wolfmanjm/wolfstock/circuits/mosfetpcb.png

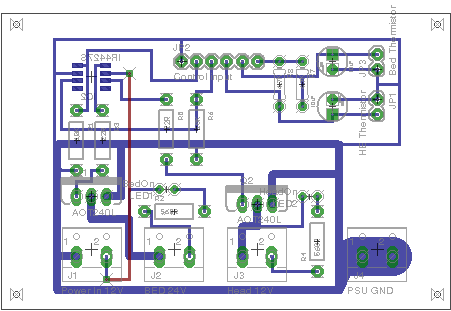
circuits/mosfetpcb.png
