wolfmanjm/wolfstock/circuits/mosfetsch.png

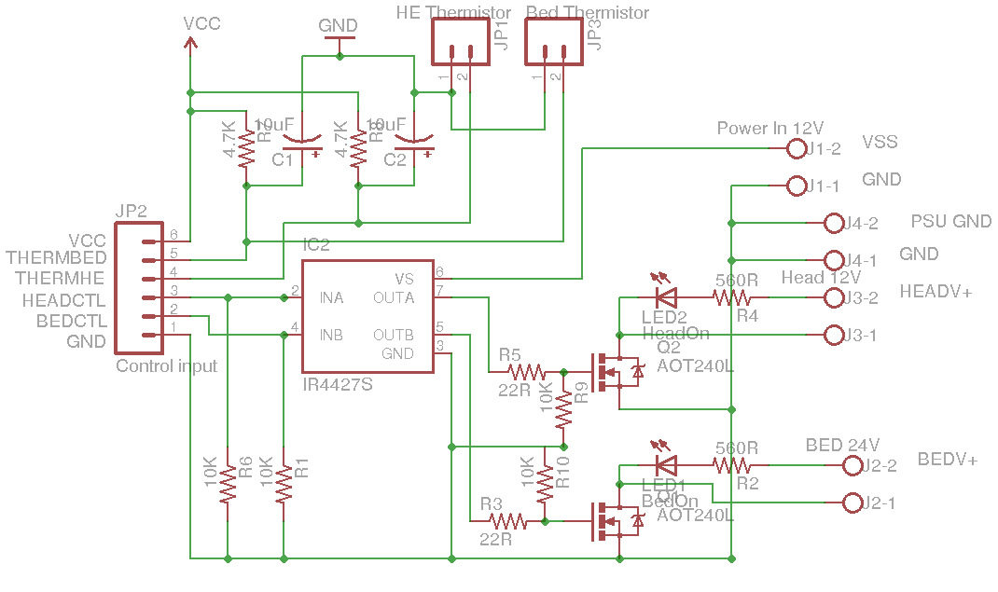
circuits/mosfetsch.png
