wolfmanjm/wolfstock/img/belt-idler.png

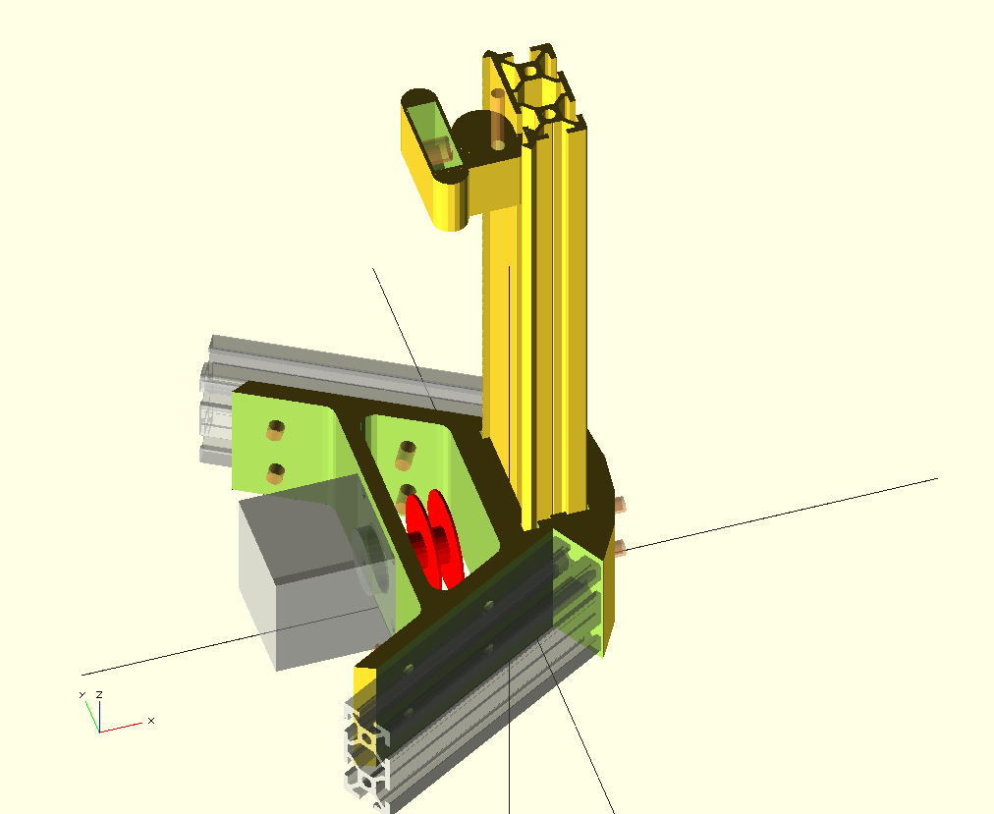
img/belt-idler.png
