wolfmanjm/wolfstock/img/g2-belt-idler.png

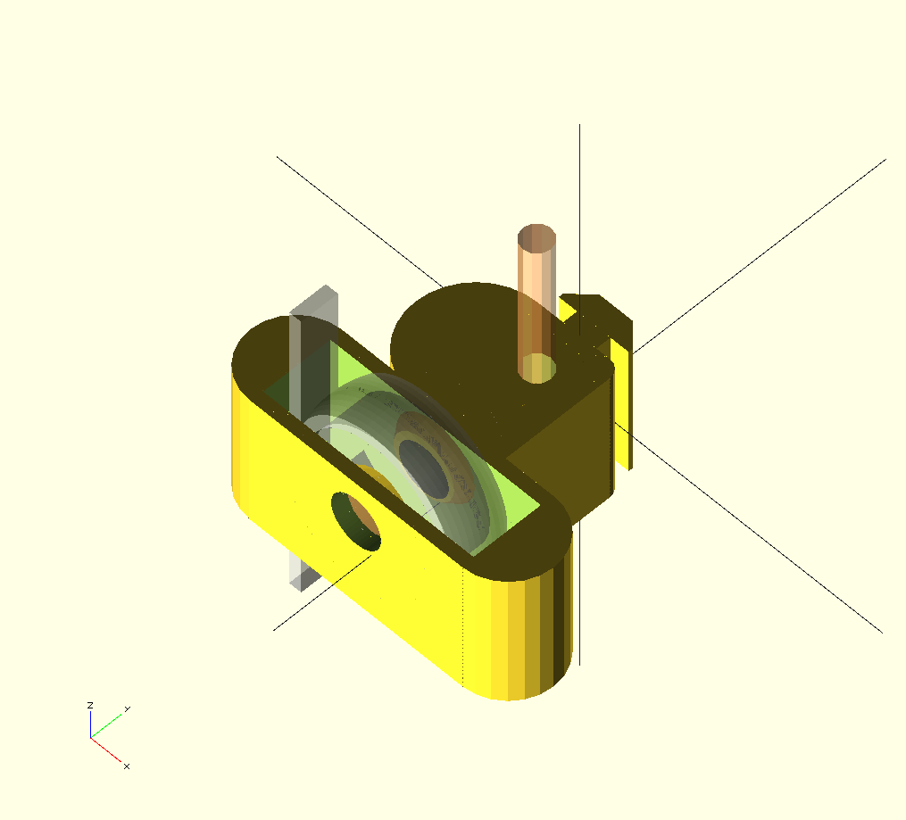
img/g2-belt-idler.png
