wolfmanjm/wolfstock/img/lite-frame.png

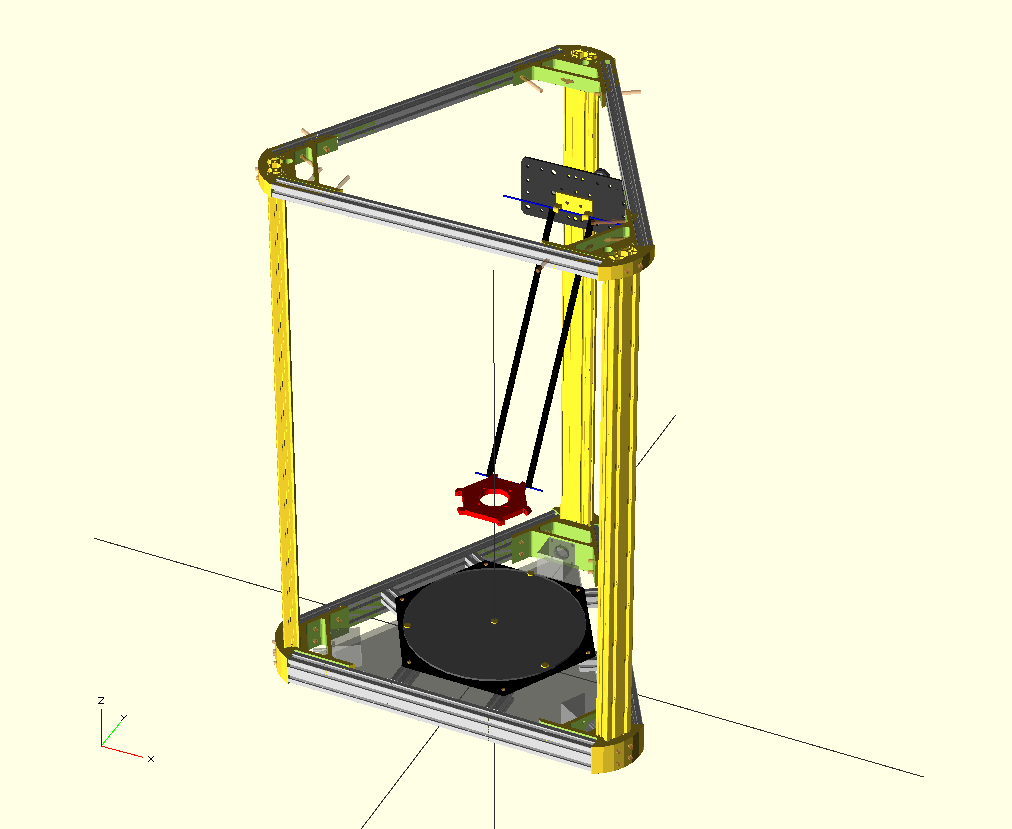
img/lite-frame.png
