wolfmanjm/wolfstock/img/rod-end.png

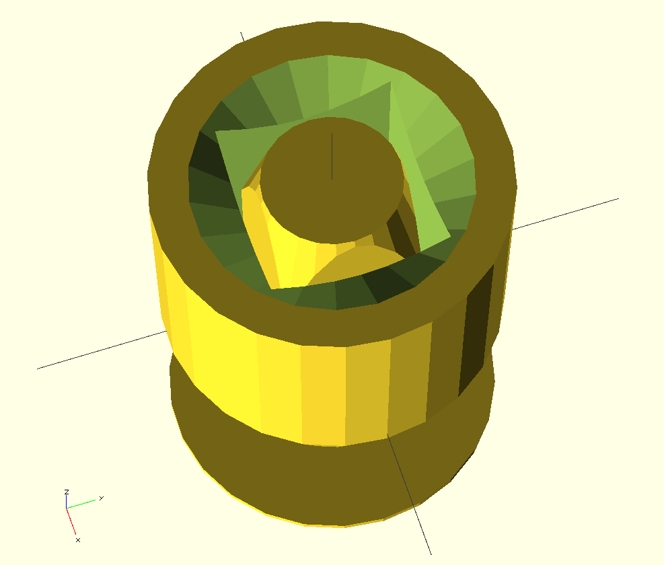
img/rod-end.png
