wolfmanjm/wolfstock/img/tensioner-top.png

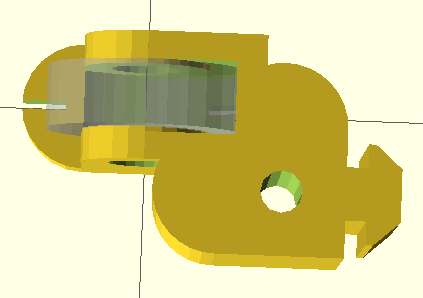
img/tensioner-top.png
