wolfmanjm/wolfstock/makerslide/makerslide_extrusion_profile.dxf

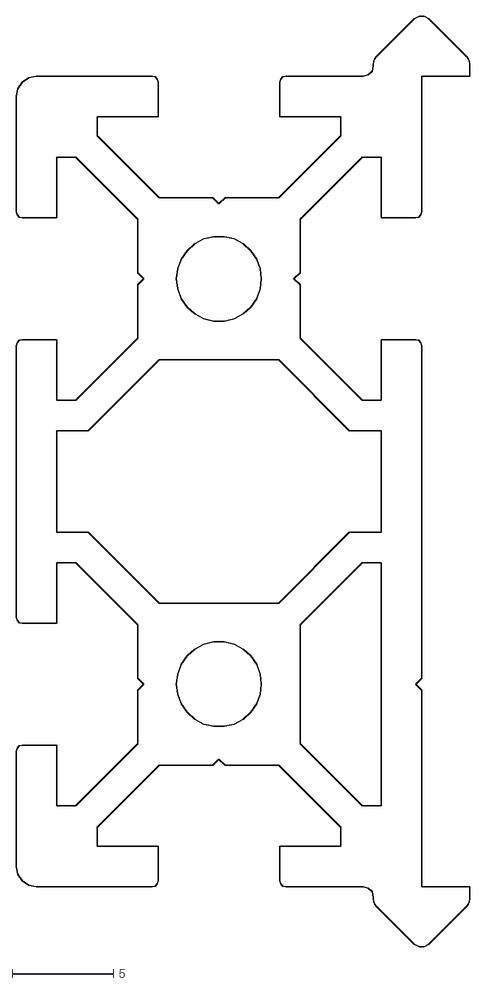
[picture p8: CAD file, 2012-12-06]
makerslide/makerslide_extrusion_profile.dxf
22.4 x 45.9
