wolfmanjm/wolfstock/smoothie-box.stl

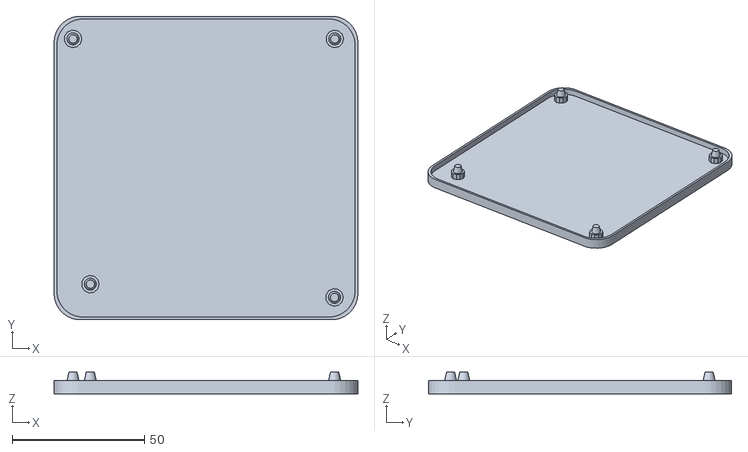
[picture p9: CAD file, 2013-08-21]
smoothie-box.stl
115.1 x 114.9 x 8.20
