wolfmanjm/wolfstock/stl/new-effector.stl

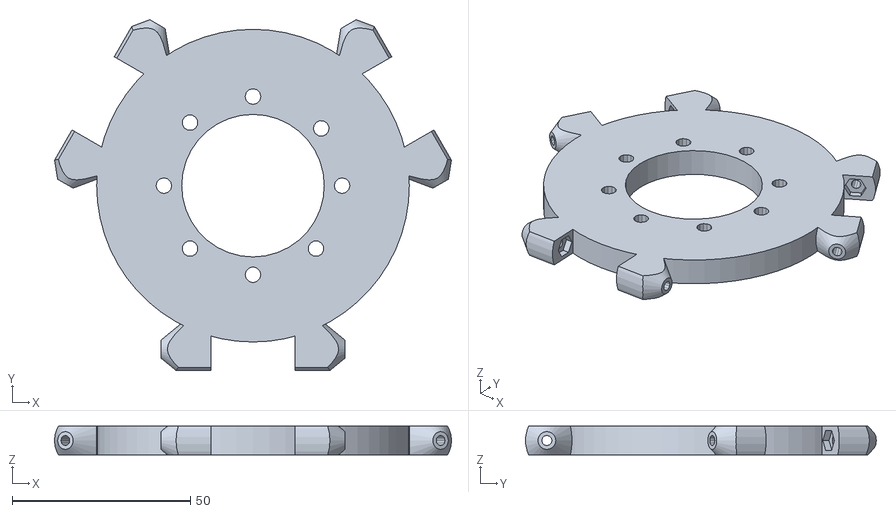
[picture p10: CAD file, 2015-06-17]
stl/new-effector.stl
111.4 x 98.4 x 8.00
