wolfmanjm/wolfstock/stl/carriage-plate.stl

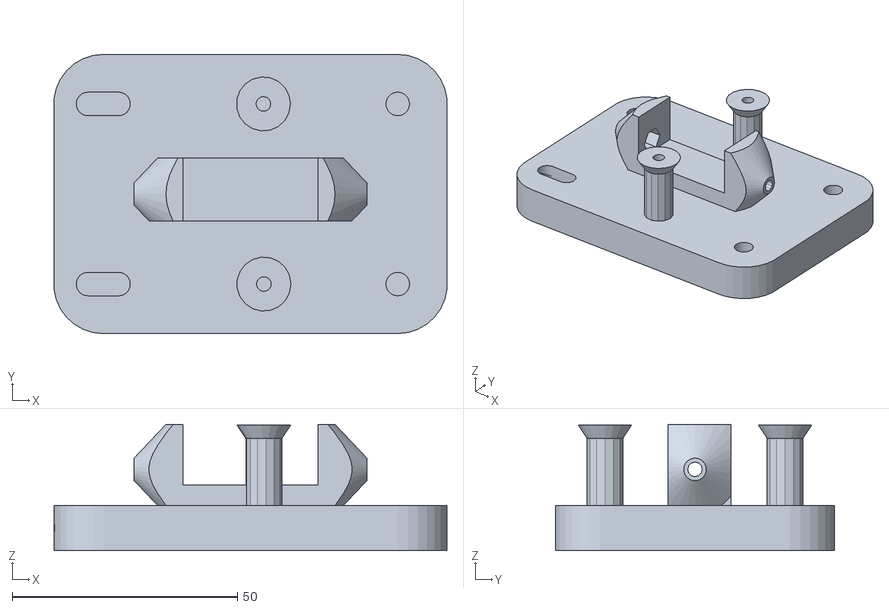
[picture p11: CAD file, 2013-09-05]
stl/carriage-plate.stl
87.3 x 62.0 x 28.1
