wolfmanjm/wolfstock/stl/gt2-carriage.stl

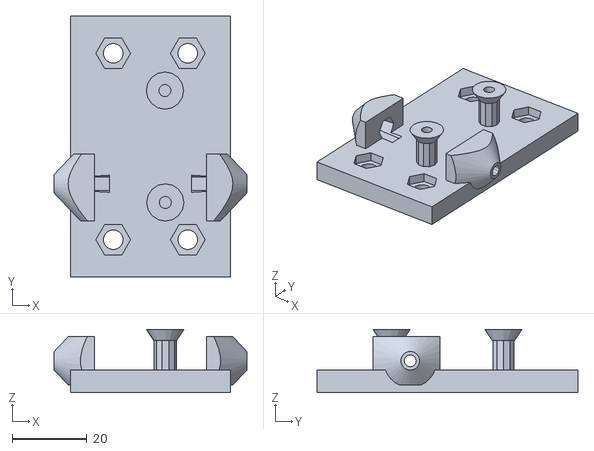
[picture p12: CAD file, 2013-09-05]
stl/gt2-carriage.stl
51.7 x 70.0 x 16.9
