wolfmanjm/wolfstock/stl/conical-spool-holder.stl

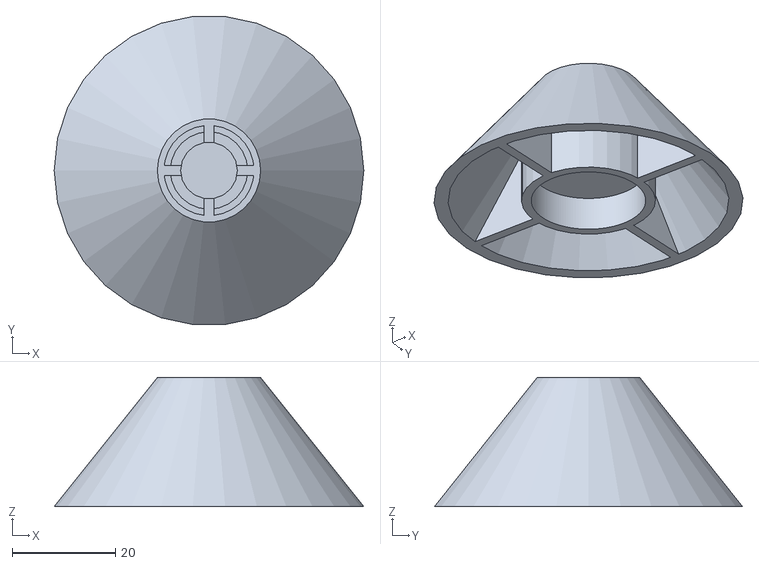
[picture p13: CAD file, 2013-08-25]
stl/conical-spool-holder.stl
60.0 x 59.7 x 25.0
