wolfmanjm/wolfstock/stl/crownedpulley-608.stl

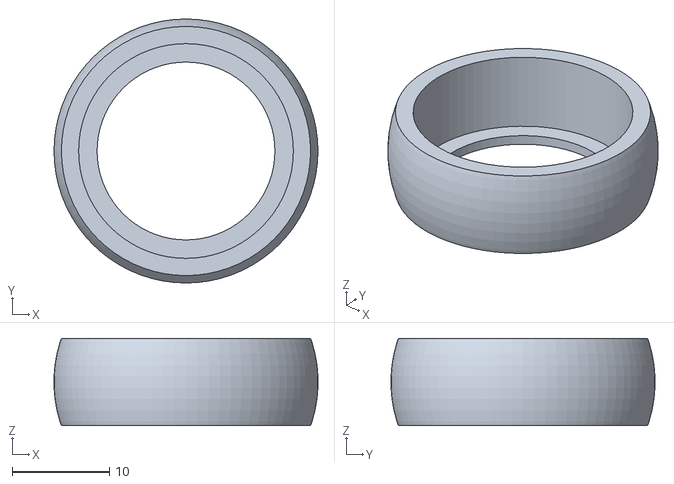
[picture p14: CAD file, 2013-08-11]
stl/crownedpulley-608.stl
27.2 x 27.2 x 9.00
