wolfmanjm/wolfstock/stl/tensioner-gt2-F695zz.stl

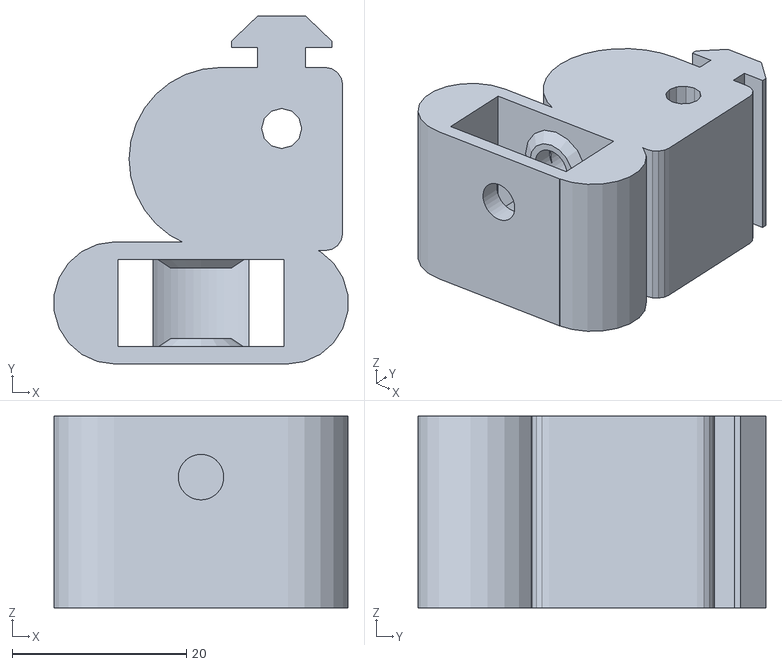
[picture p15: CAD file, 2013-08-11]
stl/tensioner-gt2-F695zz.stl
33.7 x 39.9 x 22.0
