wolfmanjm/wolfstock/stl/tensioner_g2_608.stl

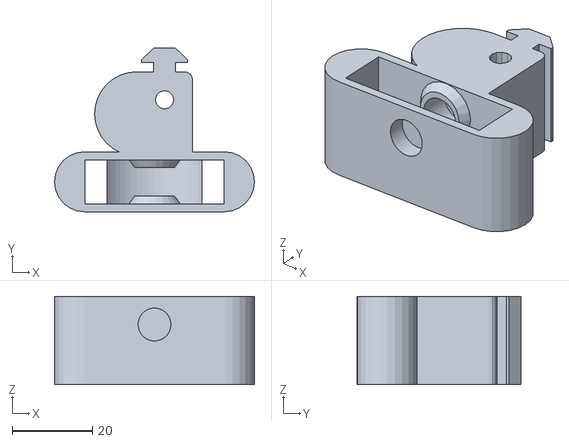
[picture p16: CAD file, 2013-08-10]
stl/tensioner_g2_608.stl
50.0 x 40.9 x 22.0
