wolfmanjm/wolfstock/stl/thumbnut.stl

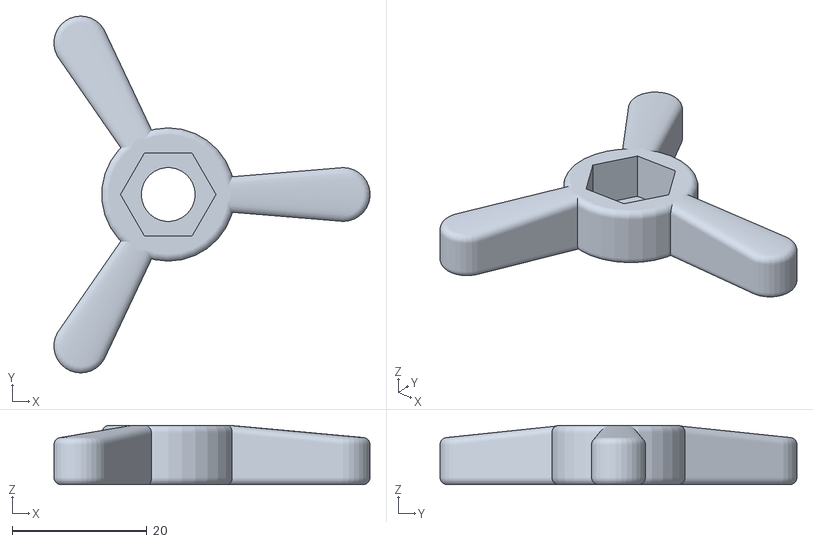
[picture p17: CAD file, 2013-08-10]
stl/thumbnut.stl
47.0 x 53.0 x 8.79
