wolfmanjm/wolfstock/stl/card.stl

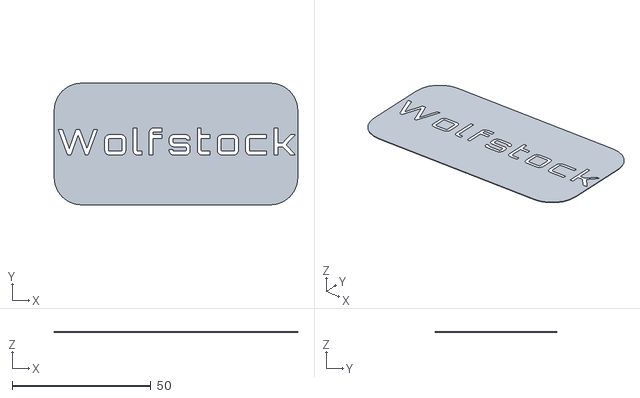
[picture p18: CAD file, 2013-07-29]
stl/card.stl
88.0 x 44.0 x 0.2
