wolfmanjm/wolfstock/stl/arm-plate-new.stl

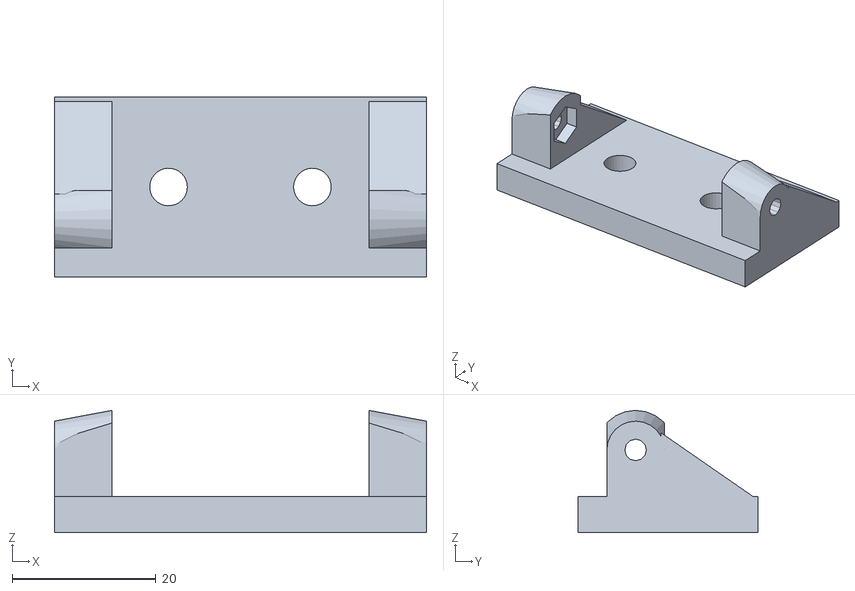
[picture p19: CAD file, 2013-07-16]
stl/arm-plate-new.stl
51.7 x 25.0 x 17.0
