wolfmanjm/wolfstock/stl/base-bracket-idler.stl

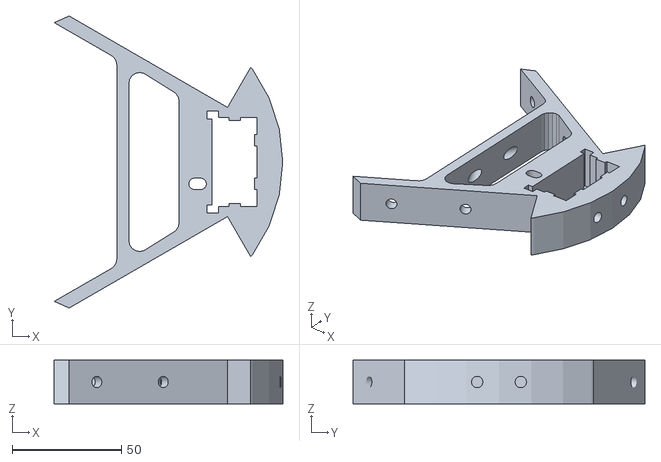
[picture p20: CAD file, 2013-07-16]
stl/base-bracket-idler.stl
104.7 x 133.8 x 20.0
