wolfmanjm/wolfstock/stl/carriage-new.stl

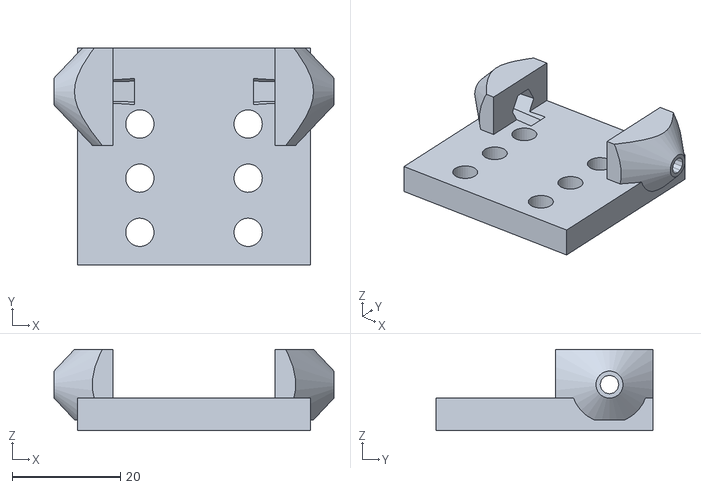
[picture p21: CAD file, 2013-07-16]
stl/carriage-new.stl
51.7 x 40.0 x 15.0
