wolfmanjm/wolfstock/stl/base-bracket-motor.stl

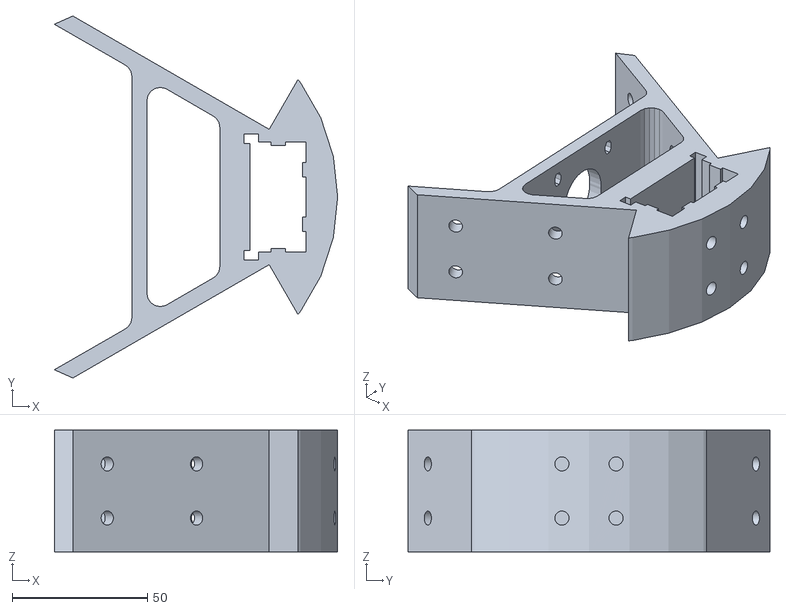
[picture p22: CAD file, 2013-07-16]
stl/base-bracket-motor.stl
104.7 x 133.8 x 45.0
