wolfmanjm/wolfstock/stl/adjustable-limit-stop-mount.stl

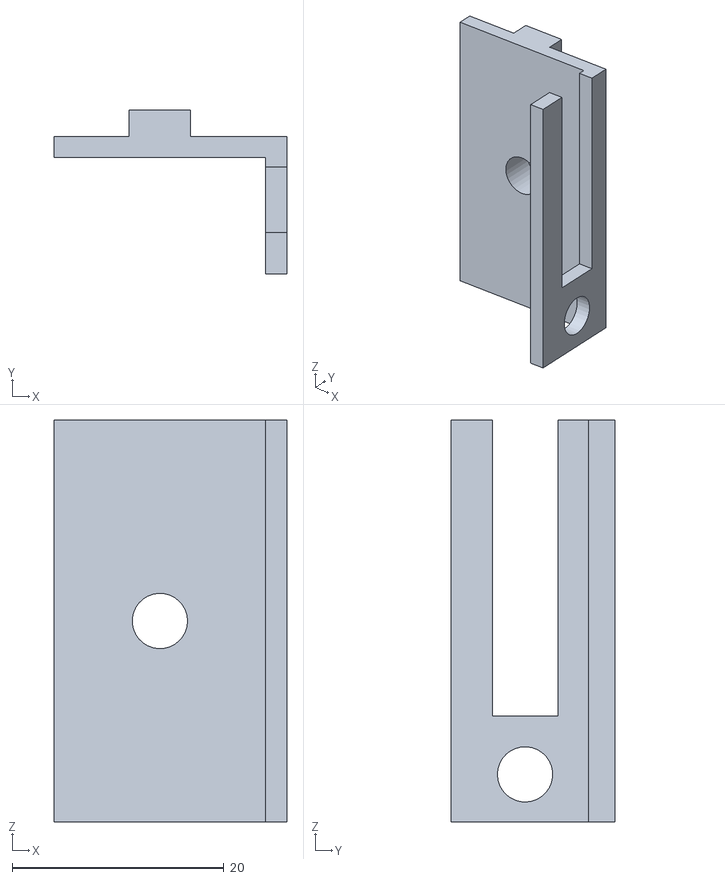
[picture p23: CAD file, 2013-03-21]
stl/adjustable-limit-stop-mount.stl
22.0 x 15.5 x 38.0
