wolfmanjm/wolfstock/stl/adjustable-limit-stop-slide.stl

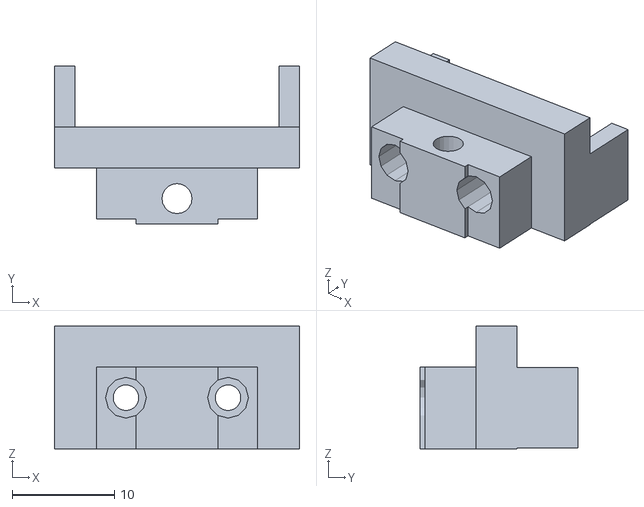
[picture p24: CAD file, 2013-02-26]
stl/adjustable-limit-stop-slide.stl
24.0 x 15.5 x 12.0
