wolfmanjm/wolfstock/stl/adjustable-limit-stop.stl

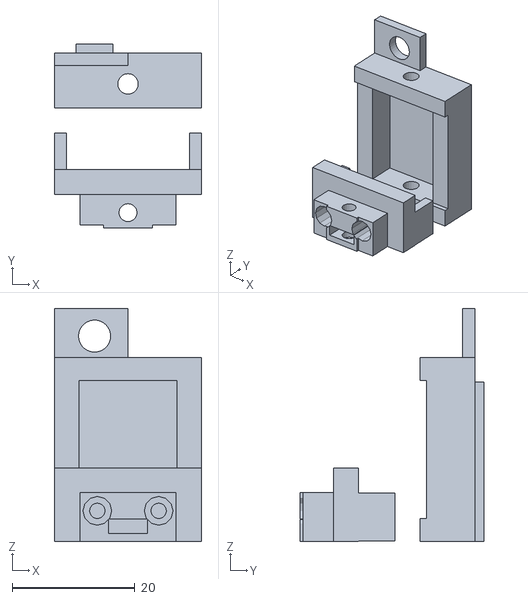
[picture p25: CAD file, 2013-02-26]
stl/adjustable-limit-stop.stl
24.0 x 30.0 x 38.0
