wolfmanjm/wolfstock/stl/adjustable-limit-stop-base.stl

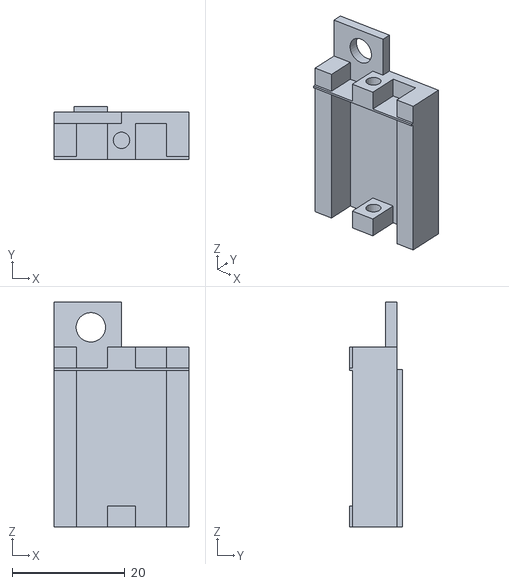
[picture p26: CAD file, 2013-02-26]
stl/adjustable-limit-stop-base.stl
24.0 x 9.40 x 40.0
