wolfmanjm/wolfstock/stl/eswitch-holder.stl

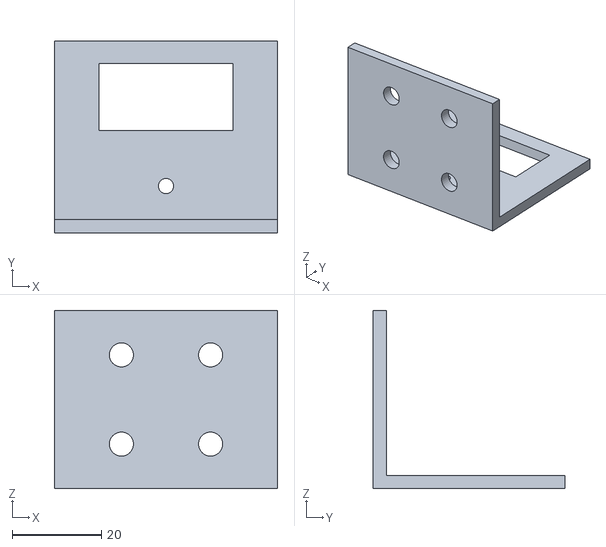
[picture p27: CAD file, 2013-01-21]
stl/eswitch-holder.stl
50.0 x 43.0 x 40.0
