wolfmanjm/wolfstock/stl/endstop.stl

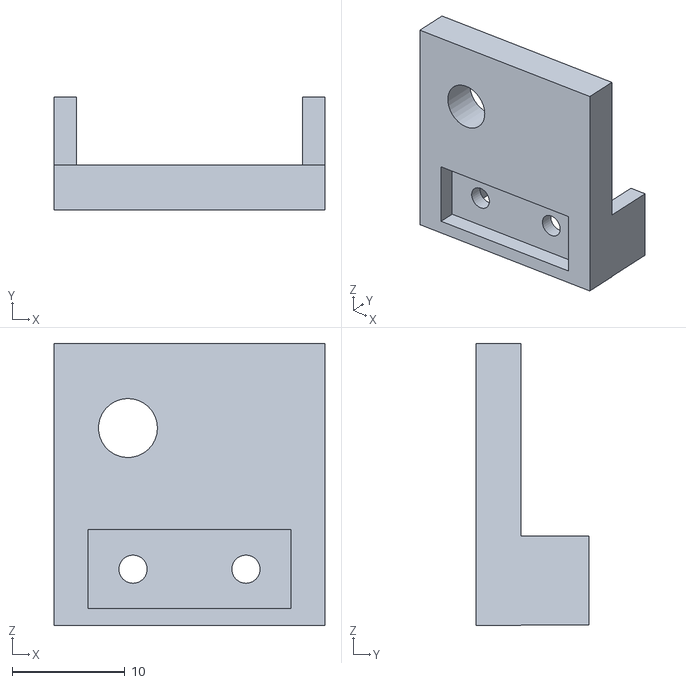
[picture p28: CAD file, 2013-01-21]
stl/endstop.stl
24.0 x 10.0 x 25.0
