wolfmanjm/wolfstock/stl/rod-end-connector.stl

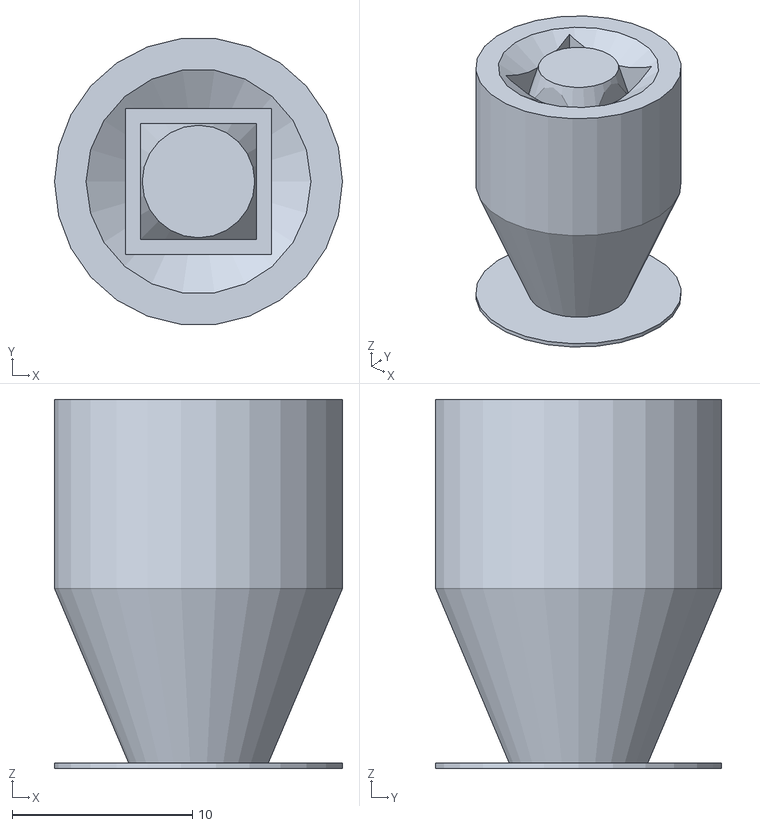
[picture p29: CAD file, 2013-01-07]
stl/rod-end-connector.stl
16.0 x 15.9 x 20.5
