wolfmanjm/wolfstock/stl/2020-insert.stl

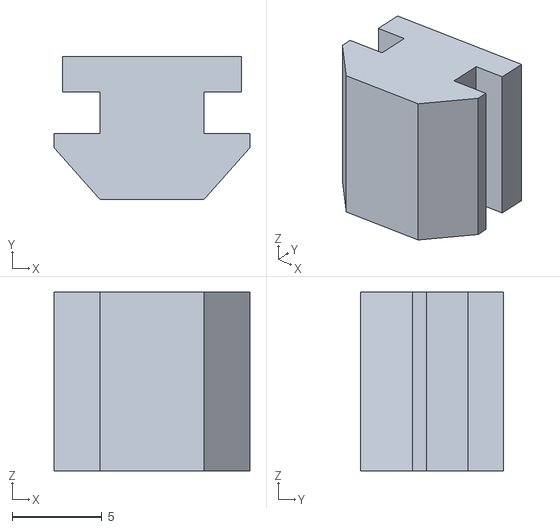
[picture p30: CAD file, 2013-01-07]
stl/2020-insert.stl
10.9 x 8.00 x 10.0
