wolfmanjm/wolfstock/stl/effector.stl

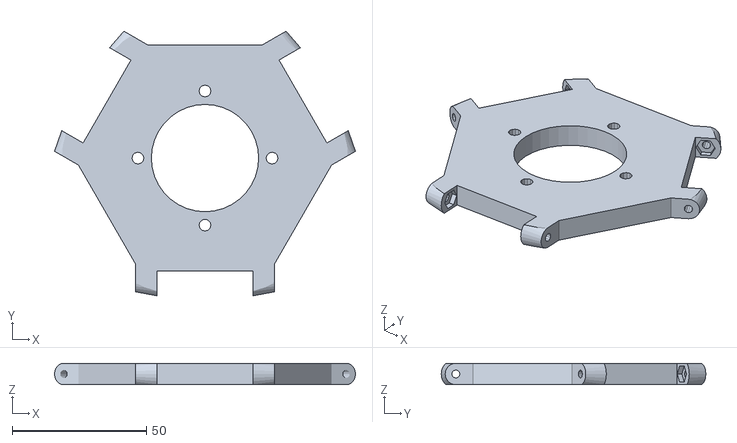
[picture p31: CAD file, 2013-01-07]
stl/effector.stl
112.2 x 98.7 x 8.00
