wolfmanjm/wolfstock/stl/tensioner_608.stl

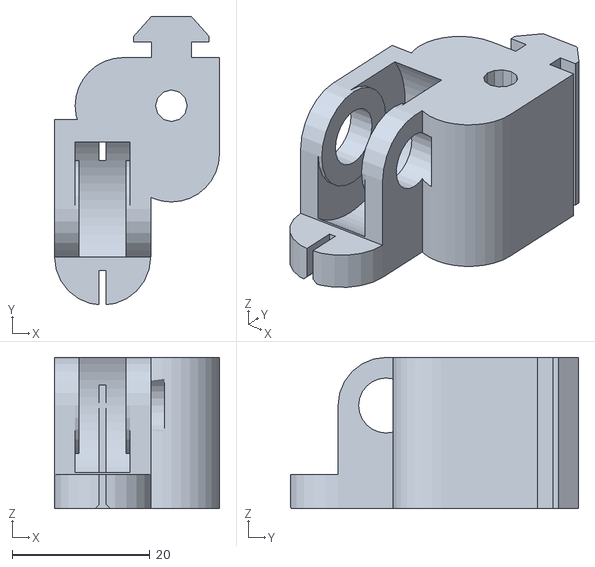
[picture p32: CAD file, 2013-01-07]
stl/tensioner_608.stl
24.0 x 41.9 x 22.0
