wolfmanjm/wolfstock/stl/tnut.stl

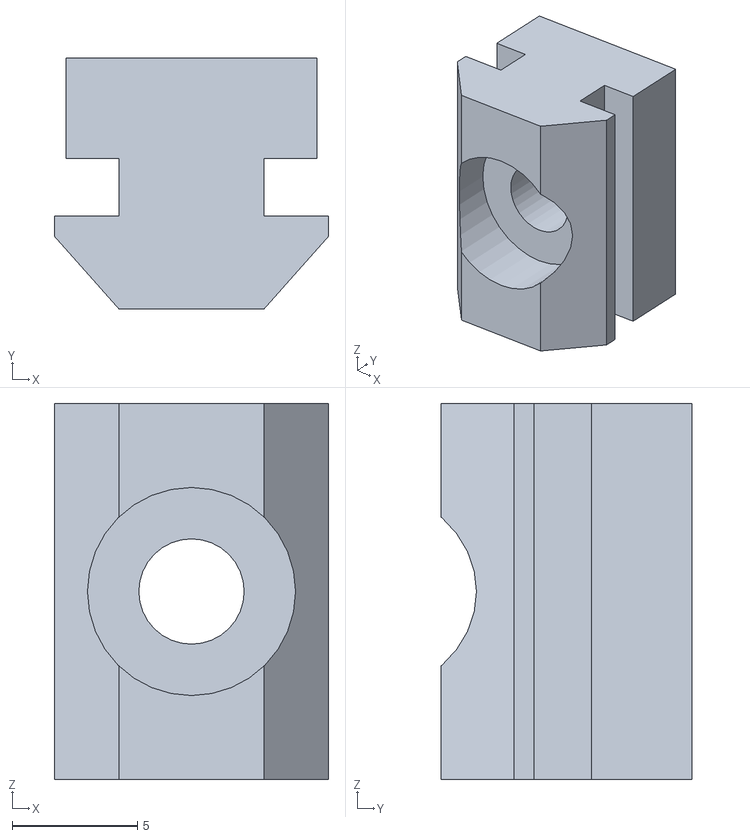
[picture p33: CAD file, 2013-01-07]
stl/tnut.stl
10.9 x 10.0 x 15.0
