wolfmanjm/wolfstock/configuration.scad

// Increase this if your slicer or printer make holes too tight.
extra_radius = 0.0;

// OD = outside diameter, corner to corner.
m3_nut_od = 6.1;
m3_nut_radius = m3_nut_od/2 + 0.2 + extra_radius;

// Major diameter of metric 3mm thread.
m3_major = 2.85;
m3_radius = m3_major/2 + extra_radius;
m3_wide_radius = m3_major/2 + 0.2 + extra_radius;

// NEMA17 stepper motors.
motor_shaft_diameter = 5;
motor_shaft_radius = motor_shaft_diameter/2 + extra_radius;

// Frame brackets.
thickness = 3.6;
