wolfmanjm/wolfstock/carriage-new.scad

/*
 * Based on Johanns mini kossel design
 * https://github.com/jcrocholl/kossel
 */
include <configuration.scad>;

use <carriage_plate_standard_c14005_rev_2.scad>
use <myLibs.scad>

//separation = 40;
ratio= 1.39;
separation = 37.2*ratio;
echo(str("Separation= ", separation));

thickness = 6;

horn_thickness = 13;
horn_x = 15;
horn_offset = 2;

belt_width = 6;
belt_x = 5.6;
belt_z = 7;

module carriage() {
  // Timing belt (up and down).
  translate([-belt_x, 0, belt_z + belt_width/2]) %
    cube([1.7, 100, belt_width], center=true);
  translate([belt_x, 0, belt_z + belt_width/2]) %
    cube([1.7, 100, belt_width], center=true);
  difference() {
    union() {
      // Main body.
      translate([0, 4, thickness/2])
        cube([43, 40, thickness], center=true);
      // Ball joint mount horns.
      for (x = [-1, 1]) {
        scale([x, 1, 1]) intersection() {
          translate([0, 15, horn_thickness/2+horn_offset])
            cube([separation, 18, horn_thickness], center=true);
          translate([horn_x, 16, horn_thickness/2+horn_offset]) rotate([0, 90, 0])
            cylinder(r1=14, r2=2.5, h=separation/2-horn_x);
        }
      }
      // Belt clamps.
      *difference() {
        union() {
          translate([6.5, -2.5, horn_thickness/2+1])
            cube([14, 7, horn_thickness-2], center=true);
          translate([10.75, 2.5, horn_thickness/2+1])
            cube([5.5, 16, horn_thickness-2], center=true);
        }
        // Avoid touching diagonal push rods (carbon tube).
        translate([20, -10, 12.5]) rotate([35, 35, 30])
          cube([40, 40, 20], center=true);
      }
      *for (y = [-12, 7]) {
        translate([1.25, y, horn_thickness/2+1])
          cube([7, 8, horn_thickness-2], center=true);
      }
    }
    // Screws for linear slider.
    for (x = [-10, 10]) {
      for (y = [-10, 0, 10]) {
        #translate([x, y, thickness-30/2]) hole(5, 30);
      }
    }
    // Screws for ball joints.
    translate([0, 16, horn_thickness/2+horn_offset]) rotate([0, 90, 0]) #
      cylinder(r=m3_wide_radius, h=60, center=true, $fn=12);
    // Lock nuts for ball joints.
    for (x = [-1, 1]) {
      scale([x, 1, 1]) intersection() {
        translate([horn_x, 16, horn_thickness/2+horn_offset]) rotate([90, 0, -90])
          cylinder(r1=m3_nut_radius, r2=m3_nut_radius+0.5, h=8,
                   center=true, $fn=6);
      }
    }
  }
}

carriage();

%translate([0,-10,-3.175]) rotate([0,0,0]) translate([-90/2,-160/2,0]) standard_wheel_carriage_plate();
//%translate([0,0,-3.175]) rotate([0,0,90]) translate([-90/2,-160/2,0]) standard_wheel_carriage_plate();
