wolfmanjm/wolfstock/effector.scad

include <configuration.scad>;

ratio= 1.39;
separation = 37.2*ratio;
radius = 33*ratio;
height = 8;
cone_r1 = height/2;
cone_r2 = 5.5;

echo("Separation= ", separation);
echo("Radius= ", radius);

difference() {
  union() {
    cylinder(r=separation-3, h=height, center=true, $fn=6);
    for (a = [60:120:359]) rotate([0, 0, a]) {
      translate([0, radius, 0]) intersection() {
        cube([separation, 20, height], center=true);
        union() {
          for (s = [-1, 1]) scale([s, 1, 1]) {
            translate([separation/2-4, 0, 0]) rotate([0, 90, 0])
              cylinder(r1=cone_r2, r2=cone_r1, h=8, center=true, $fn=24);
            translate([separation/2-4, -5, 0])
              cube([8, 10, height], center=true);
          }
        }
      }
    }
  }
  for (a = [60:120:359]) rotate([0, 0, a]) {
    translate([0, radius, 0]) rotate([0, 90, 0])
      cylinder(r=1.5, h=separation+1, center=true, $fn=12);
    translate([0, radius, 0]) rotate([90, 0, 90])
      cylinder(r=m3_nut_radius, h=separation-12, center=true, $fn=6);
  }
  cylinder(r=20, h=height+1, center=true, $fn=36);
  for (a = [0:90:359]) rotate([0, 0, a]) {
    translate([0, 25, 0])
      cylinder(r=2.2, h=2*height, center=true, $fn=12);
  }
}

%cylinder(r= radius, h=2);
%rotate([0,90,180]) translate([0, radius, 0]) cylinder(r= 3/2, h= separation, center=true);

//translate([0, 0, 10])  import("new-effector.stl");
