wolfmanjm/wolfstock/(list of files, cad)

Other CAD files:
vwheel_single_bearing_b17001_rev_2.scad
src/base-bracket-motor.scad
base-bracket-idler.scad
tensioner_608.scad
tensioner_g2_608.scad
MCAD/screw.scad
MCAD/shapes.scad
MCAD/teardrop.scad
src/base-bracket-idler.scad
src/effector.scad
src/endstop.scad
src/eswitch-holder.scad
src/lite-frame.scad
src/myLibs.scad
src/tensioner-gt2-F695zz.scad
src/tensioner_608.scad
src/tensioner_g2_608.scad
MCAD/bearing.scad
MCAD/bitmap/alphabet_block.scad
MCAD/bitmap/bitmap.scad
MCAD/bitmap/height_map.scad
MCAD/bitmap/letter_necklace.scad
MCAD/bitmap/name_tag.scad
MCAD/boxes.scad
MCAD/constants.scad
MCAD/curves.scad
MCAD/gears.scad
MCAD/gridbeam.scad
MCAD/hardware.scad
MCAD/involute_gears.scad
MCAD/materials.scad
MCAD/math.scad
MCAD/metric_fastners.scad
MCAD/motors.scad
MCAD/nuts_and_bolts.scad
MCAD/regular_shapes.scad
MCAD/servos.scad
MCAD/stepper.scad
MCAD/triangles.scad
MCAD/units.scad
MCAD/utilities.scad
Orbitron_Medium.scad
misumi/hblfsd5.stl
misumi/hblfsn5.stl
misumi/hblfsnf5.stl
misumi/hblfssw5.stl
misumi/hblsd5.stl
misumi/hblss5.stl
misumi/hblts5.stl
misumi/hfs5_2020_50.stl
misumi/hfs5_2040_500.stl
misumi/hfs60a5_20_100.stl
motor-mount-old.scad
src/configuration.scad
