wolfmanjm/wolfstock/img/g2-idler-assembly.png

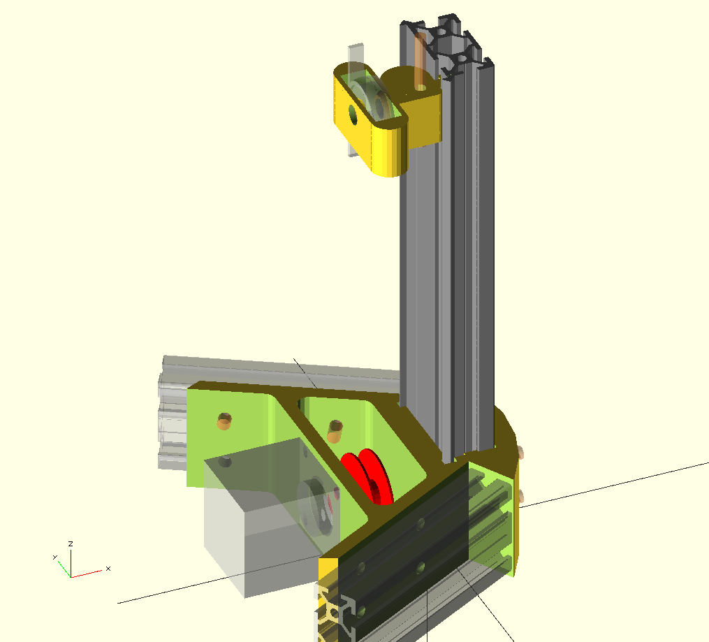
img/g2-idler-assembly.png
