wolfmanjm/wolfstock/circuits/mosfet2.brd

## EAGLE design circuits/mosfet2.brd (2013-06-11)

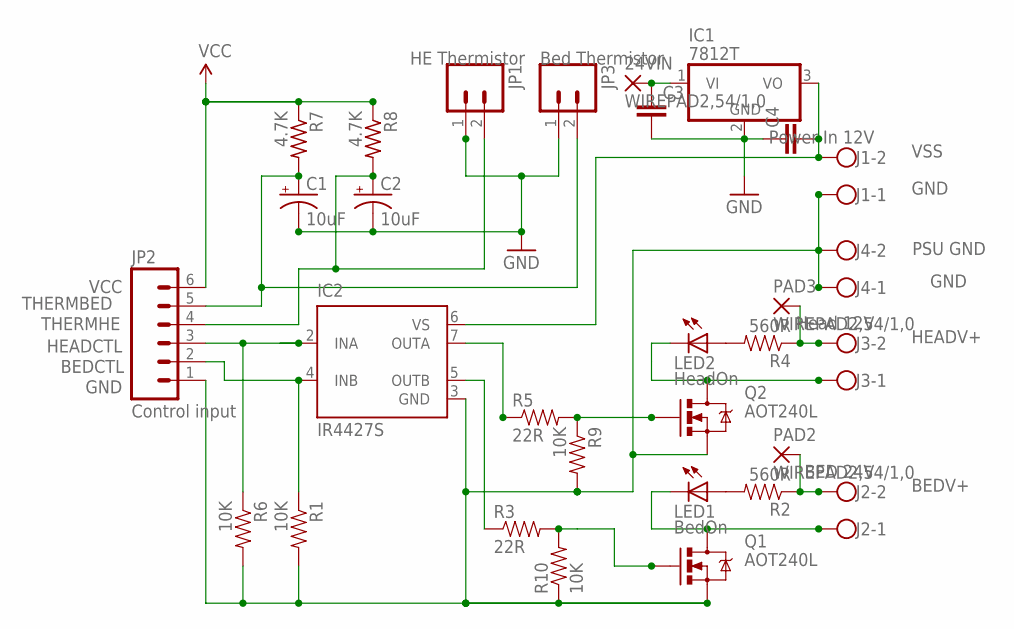
[picture p35: schematic mosfet2.sch]

Parts:
24VIN: WIREPAD2,54/1,0; 2,54/1,0
C1, C2: 10uF; CPOL-RADIAL-10UF-25V
C3, C4: CAPEZ; CAP-PTH-SMALLEZ
IC1: 7812T; TO220H
IC2: IR4427S; SO08
J1: Power In 12V; W237-102
J2: BED 24V; W237-102
J3: Head 12V; W237-102; MPN 237-102
J4: PSU GND; W237-102
JP1: HE Thermistor; 1X02
JP2: Control input; 1X06
JP3: Bed Thermistor; 1X02
LED1: BedOn; LED3MM-NS
LED2: HeadOn; LED3MM-NS
PAD2, PAD3: WIREPAD2,54/1,0; 2,54/1,0
Q1, Q2: AOT240L; TO220V
R1, R6, R9, R10: 10K; AXIAL-0.4
R2, R4: 560R; AXIAL-0.4
R3, R5: 22R; AXIAL-0.4
R7, R8: 4.7K; 0204/7

Connections:
BEDCTL: IC2.4 (INB), JP2.2, R1.P$1 (1)
BEDV+: J2.2, PAD2.1, R2.P$1 (1)
GND: C1.2 (-), C2.2 (-), C3.2, C4.1, IC1.2 (GND), IC2.3 (GND), J1.1, J4.1, J4.2, JP1.1, JP2.1, JP3.1, Q1.3 (S), Q2.3 (S), R1.P$2 (2), R6.P$2 (2), R9.P$2 (2), R10.P$1 (1)
HEADCTL: IC2.2 (INA), JP2.3, R6.P$1 (1)
HEADV+: J3.2, PAD3.1, R4.P$1 (1)
unnamed: 24VIN.1, C3.1, IC1.1 (VI)
unnamed: IC2.5 (OUTB), R3.P$1 (1)
unnamed: Q1.1 (G), R3.P$2 (2), R10.P$2 (2)
unnamed: LED1.A, R2.P$2 (2)
unnamed: J2.1, LED1.K (C), Q1.2 (D)
unnamed: LED2.A, R4.P$2 (2)
unnamed: Q2.1 (G), R5.P$2 (2), R9.P$1 (1)
unnamed: IC2.7 (OUTA), R5.P$1 (1)
unnamed: J3.1, LED2.K (C), Q2.2 (D)
THERMBED: C1.1 (+), JP2.5, JP3.2, R7.2
THERMHE: C2.1 (+), JP1.2, JP2.4, R8.2
VCC: JP2.6, R7.1, R8.1
VSS: C4.2, IC1.3 (VO), IC2.6 (VS), J1.2

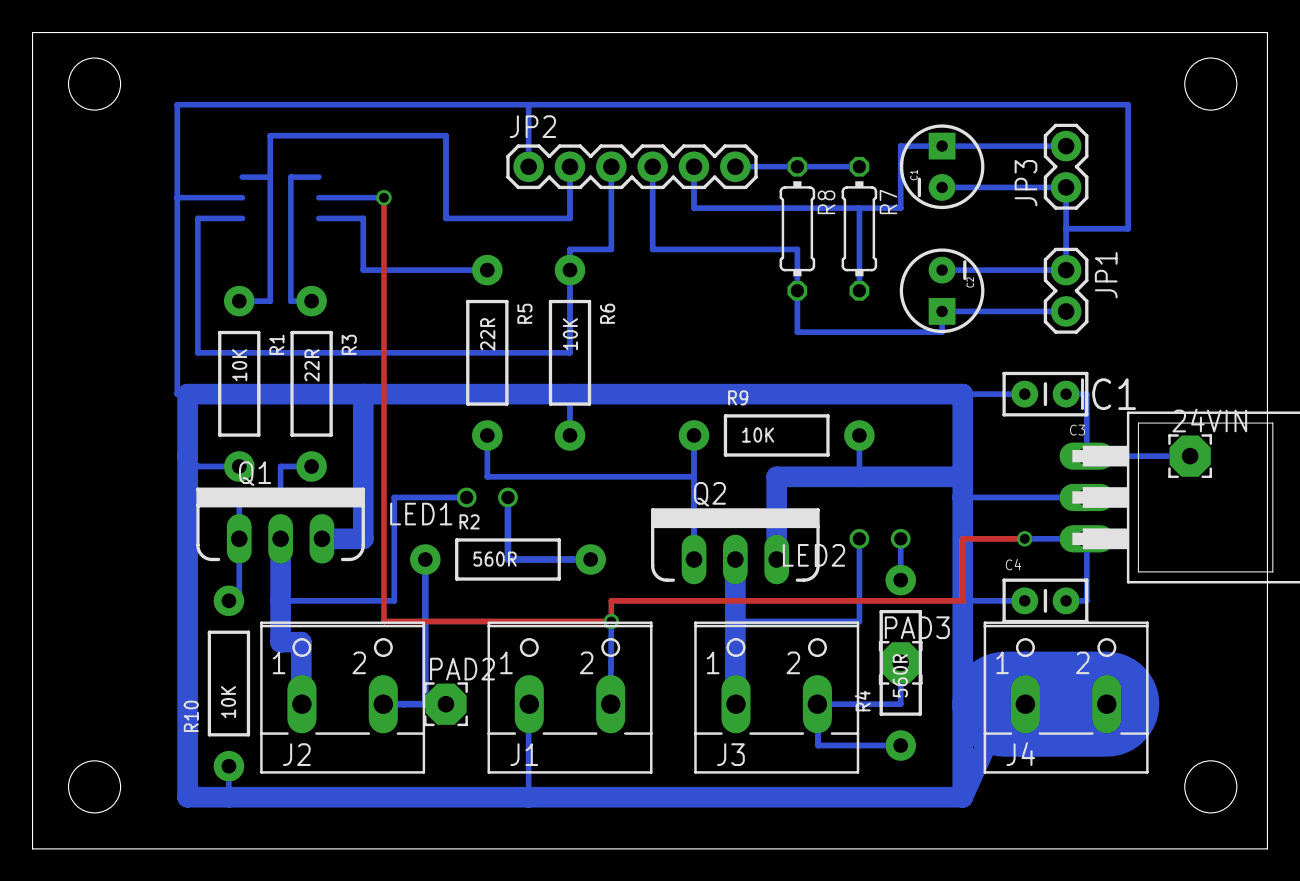
[picture p36: board mosfet2.brd from above]

Board: 2 copper layers, 75.9 x 50.2 mm, 30 parts (1 on the bottom side), 18 nets.
