wolfmanjm/wolfstock/(commit log)

2012-12-06 initial checkin
    [carriage_plate_standard_c14005_rev_2.scad, frame-square-T.scad, hblfsn5.stl, hblfsnf5.stl, hblsd5.stl, hblss5.stl, hfs5_2040_500.stl, hfs60a5_20_100.stl]
2012-12-06 added motor
    [frame-square-T.scad, motor-mount.scad]
2012-12-06 add attachment holes to motor braccket
    [frame-square-T.scad, motor-mount.scad]
2012-12-07 added angked plate, motor mount
    [arm-plate.scad, arm-plate.stl, frame-square-T.scad, motor-mount-old.scad]
2012-12-07 tweak motor mount to allow motor inside added buttress support to motors.
    [frame-square-T.scad, motor-mount.scad]
2012-12-23 added new files. changed tensioner to use slider profile
    [2020-insert.scad, carriage_plate_standard_c14005_rev_2.scad, frame-square-T.scad, hblfsd5.stl, hblfssw5.stl, hblts5.stl, misumi-parts-library.scad, mod-spool1.scad]
2013-01-07 added new files
    [arm-mount.scad, arm-plate.scad, configuration.scad, effector.scad, frame-square-T.scad, mod-spool1.scad, rod-end-connector.scad, tensioner_608.scad]
2013-01-07 thickened arm plates added base for rod end
    [arm-plate.scad, rod-end-connector.scad]
2013-01-07 move gcode and stl to build
    [arm-plate.stl]
2013-01-07 fix stl locations
    [frame-square-T.scad]
2013-01-09 update readme add visual of build area and round glass.
    [frame-square-T.scad]
2013-01-09 added src directory which seems to be needed for githubiverse to work
    [arm-mount.scad, arm-plate.scad, configuration.scad, effector.scad, mod-spool1.scad, motor-mount.scad, rod-end-connector.scad, tensioner_608.scad]
2013-01-09 remove links
    [arm-mount.scad, arm-plate.scad, configuration.scad, effector.scad, mod-spool1.scad, motor-mount.scad, rod-end-connector.scad, tensioner_608.scad]
2013-01-09 added grabbers idler scad
    [v-idler.scad, v-idler.stl]
2013-01-10 beef up the angled arm plates make a print plate for them
    [arm-plate.scad, arm-plates-print.stl]
2013-01-10 copy to src
    [arm-plate.scad]
2013-01-10 new tensioner using grabbers vwheel
    [tensioner_vwheel.scad, tensioner_vwheel.stl]
2013-01-18 minor updates
    [frame-square-T.scad]
2013-01-21 new parts
    [endstop.scad, endstop.stl, eswitch-holder.scad, eswitch-holder.stl, limit_switch.scad, myLibs.scad]
2013-01-21 added src
    [endstop.scad, eswitch-holder.scad, myLibs.scad]
2013-04-04 add circuits
    [mosfet2.brd, mosfet2.sch]
2013-06-11 update mosfet circuit
    [frame-square-T.scad, misumi-parts-library.scad, mosfet2.brd, mosfet2.sch]
2013-06-29 added first pass at kossel-like base frame bracket
    [base-bracket-motor.scad, base-bracket-motor.stl]
2013-06-29 completed motor bracket
    [base-bracket-motor.scad, base-bracket-motor.stl]
2013-06-29 added overall frame
    [lite-frame.scad]
2013-06-29 turn idler sideways
    [base-bracket-motor.scad, tensioner_608.scad]
2013-06-29 make motor mount holes a little bigger
    [base-bracket-motor.scad, base-bracket-motor.stl, lite-frame.scad]
2013-06-29 add calculated positioning
    [lite-frame.scad]
2013-06-29 Place all beams via calcualtions
    [lite-frame.scad]
2013-06-29 add MCAD
    [alphabet_block.scad, base-bracket-motor.scad, bearing.scad, bitmap.scad, boxes.scad, constants.scad, curves.scad, gears.scad]
2013-06-29 add in build area and carriage
    [lite-frame.scad]
2013-07-01 added top bracket for 2020 using exisiting spectra idler
    [arm-plate.scad, base-bracket-idler.scad, base-bracket-idler.stl, tensioner_608.scad]
2013-07-01 add indent for idelr screw added image of lite frame
    [base-bracket-idler.scad]
2013-07-02 tweaked for old bracket size
    [lite-frame.scad]
2013-07-02 Make it bigger so traxxas can get to most of the 250mm print bed
    [lite-frame.scad]
2013-07-04 add bed bracket
    [lite-frame.scad]
2013-07-05 add top brackets
    [lite-frame.scad]
2013-07-06 add buttress to arm plate
    [arm-plate.scad, lite-frame.scad]
2013-07-06 add calibration points
    [lite-frame.scad]
2013-07-09 added new carriage to hold arms
    [arm-plate.scad, carriage-new.scad, carriage-new.stl]
2013-07-16 removed old files
    [arm-plate-back.stl, arm-plate-left.stl, arm-plate-right.stl, arm-plate.stl, arm-plates-print.stl, mod-spool1.stl, motor-mount.stl, support-bracket.stl]
2013-07-16 added relevant src files
    [arm-mount.scad, arm-plate.scad, base-bracket-idler.scad, base-bracket-motor.scad, carriage-new.scad, frame-square-T.scad, lite-frame.scad, mod-spool1.scad]
2013-07-16 add new stl
    [arm-plate-new.stl, base-bracket-idler.stl, base-bracket-motor.stl, carriage-new.stl]
2013-07-16 added BOM
2013-07-16 update bom
2013-07-18 add idler/tensioner for belt system
    [tensioner_g2_608.scad]
2013-07-19 get spacing for gt2 correct
    [base-bracket-motor.scad, lite-frame.scad, tensioner_g2_608.scad]
2013-07-19 add the 608 crowned pulley
    [crownedpulley.scad]
2013-07-19 add pic of belt idler
    [crownedpulley.scad]
2013-07-20 Make left side of belt straight into idler
    [base-bracket-motor.scad, crownedpulley.scad, tensioner_g2_608.scad]
2013-07-20 Make tensioner wall thicker
    [tensioner_g2_608.scad, tensioner_g2_608.stl]
2013-07-20 add belt tensioner and new arm brackets
    [lite-frame.scad]
2013-07-20 more clearance for tslot plug Increase clearance for crowned pulley
    [2020-insert.scad, tensioner_g2_608.scad]
2013-07-21 start to add ability to tilt bearing shaft
    [myLibs.scad, tensioner_g2_608.scad]
2013-07-22 Add horn for bearing support
    [tensioner_g2_608.scad]
2013-07-23 strengthen eswitch holder add missing support files add an axle for the tensioner
    [eswitch-holder.scad, hfs5_2020_50.stl, tensioner_axle.scad, tensioner_g2_608.stl]
2013-07-23 update links in bom
2013-07-24 allow selection of makerslide or 2040
    [base-bracket-motor.scad]
2013-07-24 increase bearing horn length add swicth for makerslide vs vslot
    [base-bracket-idler.scad, base-bracket-motor.scad, tensioner_g2_608.scad]
2013-07-24 update the src and stl dir
    [base-bracket-idler.scad, base-bracket-motor.scad, tensioner_g2_608.scad, tensioner_g2_608.stl]
2013-07-24 added image of the g2 idler
2013-07-24 update redme to talk about the gt2 belt option
2013-07-27 first pass at a gt2 belt carriage
    [gt2-carriage.scad]
2013-07-29 add obligaroty sample card object
    [Orbitron_Medium.scad, card.scad, card.stl]
2013-07-30 added bolt lengths to readme
2013-07-30 correct bolt lengths again
2013-08-08 added the peng[os and vikilcd brackets/box new video
    [pengpod-bracket.scad, vikilcd-case.scad]
2013-08-09 updated readme and added a video made crowned pulley more "crowned"
    [crownedpulley.scad]
2013-08-10 check belt clearnce with 0.25" spacers
    [base-bracket-motor.scad, thumbnut.scad, thumbnut.stl]
2013-08-10 make gt2 tensioner longer to increase clearance from carriage to a tad over 1mm
    [base-bracket-motor.scad, tensioner_g2_608.scad, tensioner_g2_608.stl]
2013-08-10 Make crowned pulley exactly same width as 608 bearing so it fits housing
    [crownedpulley.scad, gt2-carriage.scad, tensioner_g2_608.scad]
2013-08-11 add new idler/tensioner using back to back F695zz flanged bearings
    [base-bracket-motor.scad, tensioner-gt2-F695zz.scad, tensioner-gt2-F695zz.stl]
2013-08-11 update readme file to cover the gt2 belt drive and sources
2013-08-11 added new fles to src and stl
    [crownedpulley-608.stl, crownedpulley.scad]
2013-08-12 another go at belt clamps on the carriage
    [base-bracket-motor.scad, gt2-carriage.scad, tensioner-gt2-F695zz.scad]
2013-08-12 third try at belt terminations for carriage, this one is a simple M3 reinforced post
    [gt2-carriage.scad]
2013-08-16 added alternative CF tube source
2013-08-17 added carriage plate and arm mount combined
    [carriage-plate.scad, carriage-plate.stl, myLibs.scad]
2013-08-20 tweak wheel distance
    [carriage-plate.scad]
2013-08-20 update stl
    [carriage-plate.stl]
2013-08-21 added tray for smoothie board
    [smoothie-box.scad, smoothie-box.stl]
2013-08-21 use oins for smoothie board make belt pillars thicker add some extra support for the horns
    [carriage-plate.scad, smoothie-box.scad, smoothie-box.stl]
2013-08-21 use pins to hold smoothie rather than screws
    [smoothie-box.scad, smoothie-box.stl]
2013-08-25 added a paramatric conical spool holder
    [conical-spool-holder.scad, conical-spool-holder.stl]
2013-09-03 add link to extruder I use
2013-09-05 added latest gt2 carriage for mounting on carriage plate
    [gt2-carriage.stl]
2013-09-05 beefed up a bit
    [carriage-plate.stl]
2013-09-06 repair carriage plate
    [carriage-plate.stl]
2013-11-24 update source and stl
    [carriage-plate.scad, carriage-plate.stl, gt2-carriage.scad]
2014-02-27 update readme, go from WIP to stable
    [thumbnut.scad]
2014-05-02 make endstop stick out further
    [endstop.scad, limit_switch.scad]
2014-05-15 make effector a little more robust
    [effector.scad]
2015-06-17 new effector
    [eswitch-holder.scad, misumi-parts-library.scad, new-effector.scad, new-effector.stl, teardrop.scad, vikilcd-case.scad]
